shorlee/TeleSTERN/accelerometer.kicad_sch

## KiCad design accelerometer.kicad_sch (2024-08-02)

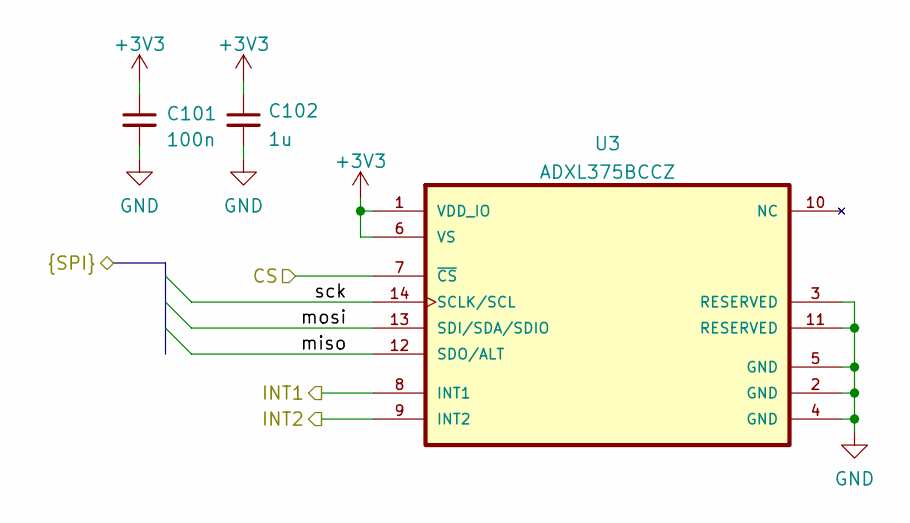
[picture p3: schematic accelerometer.kicad_sch]

Parts:
C101: 100n; C_0402_1005Metric; MPN C1005X5R1E104K050BC
C102: 1u; C_0402_1005Metric; MPN CL05A105KP5NNNC
U3: ADXL375BCCZ; ad-lga-14; MPN ADXL375BCCZ

Connections:
+3V3: C101.1, C102.1, U3.1 (VDD_IO), U3.6 (VS)
CS: U3.7 (~CS)
GND: C101.2, C102.2, U3.2 (GND), U3.3 (RESERVED), U3.4 (GND), U3.5 (GND), U3.11 (RESERVED)
INT1: U3.8 (INT1)
INT2: U3.9 (INT2)
miso: U3.12 (SDO/ALT)
mosi: U3.13 (SDI/SDA/SDIO)
sck: U3.14 (SCLK/SCL)
