shorlee/TeleSTERN/barometer.kicad_sch

## KiCad design barometer.kicad_sch (2024-08-02)

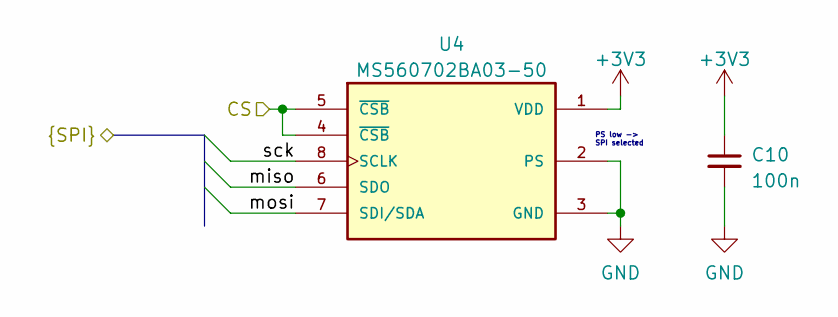
[picture p4: schematic barometer.kicad_sch]

Parts:
C10: 100n; C_0402_1005Metric; MPN C1005X5R1E104K050BC
U4: MS560702BA03-50; SON125P300X500X100-8N; MPN MS560702BA03-50

Connections:
+3V3: C10.1, U4.1 (VDD)
CS: U4.4 (~CSB), U4.5 (~CSB)
GND: C10.2, U4.2 (PS), U4.3 (GND)
miso: U4.6 (SDO)
mosi: U4.7 (SDI/SDA)
sck: U4.8 (SCLK)

Notes on the sheet:
PS low -> SPI selected
