shorlee/TeleSTERN/gps.kicad_sch

## KiCad design gps.kicad_sch (2024-08-02)

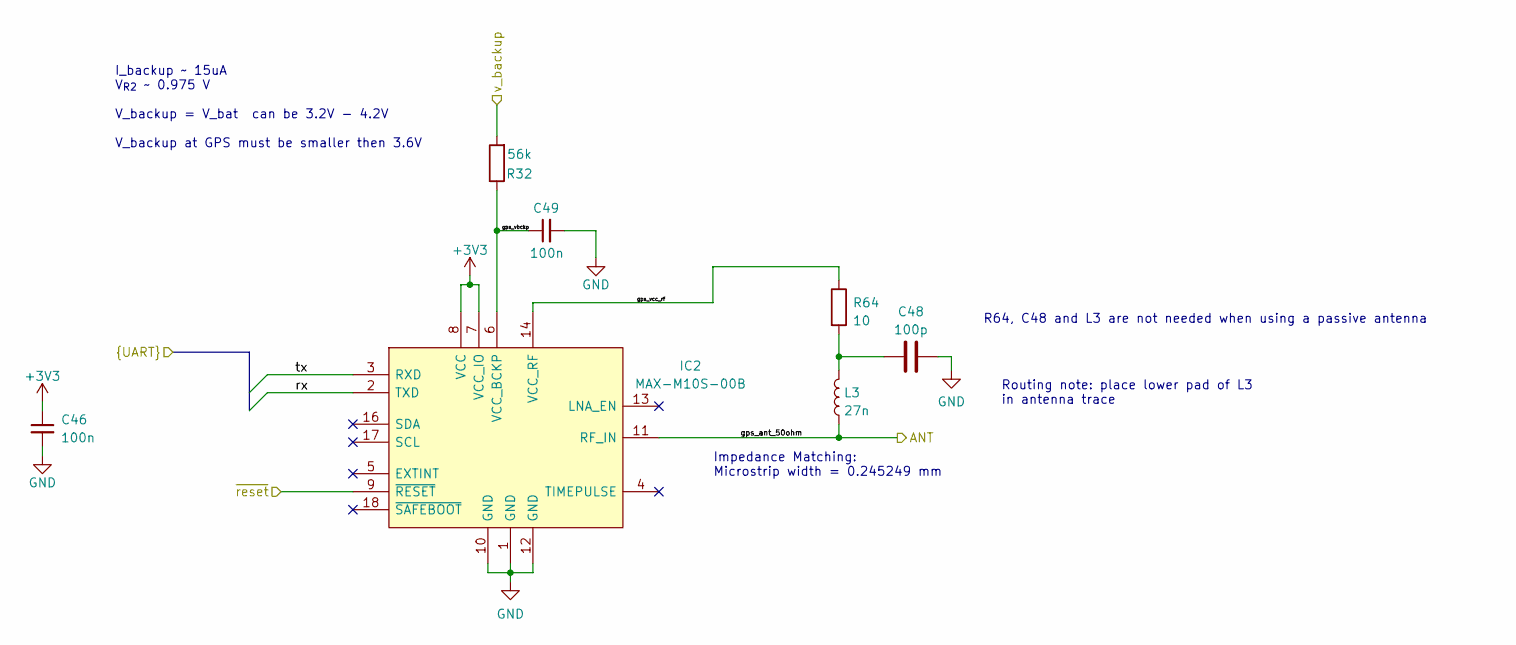
[picture p5: schematic gps.kicad_sch]

Parts:
C46, C49: 100n; C_0402_1005Metric; MPN C1005X5R1E104K050BC
C48: 100p; C_0402_1005Metric; MPN CGA2B2NP01H101J050BA
IC2: MAX-M10S-00B; MAXM10S00B; MPN MAX-M10S-00B; Digikey 672-MAX-M10S-00BTR-ND
L3: 27n; L_0402_1005Metric; MPN LQG15HS27NJ02D
R32: 56k; R_0402_1005Metric; MPN ERJ-U02F5602X
R64: 10; R_0402_1005Metric; MPN 603-RC0402FR-7W10RL

Connections:
+3V3: C46.1, IC2.7 (VCC_IO), IC2.8 (VCC)
ANT: IC2.11 (RF_IN), L3.1
GND: C46.2, C48.2, C49.2, IC2.1 (GND), IC2.10 (GND), IC2.12 (GND)
unnamed: C48.1, L3.2, R64.2
gps_vbckp: C49.1, IC2.6 (VCC_BCKP), R32.1
gps_vcc_rf: IC2.14 (VCC_RF), R64.1
rx: IC2.2 (TXD)
tx: IC2.3 (RXD)
v_backup: R32.2
~reset: IC2.9 (~RESET)

Notes on the sheet:
Impedance Matching: Microstrip width = 0.245249 mm
I_backup ~ 15uA V_{R2} ~ 0.975 V V_backup = V_bat can be 3.2V - 4.2V V_backup at GPS must be smaller then 3.6V
Routing note: place lower pad of L3 in antenna trace
R64, C48 and L3 are not needed when using a passive antenna
