shorlee/TeleSTERN/hw-tele-stern.kicad_sch

## KiCad design hw-tele-stern.kicad_sch (2024-08-02)

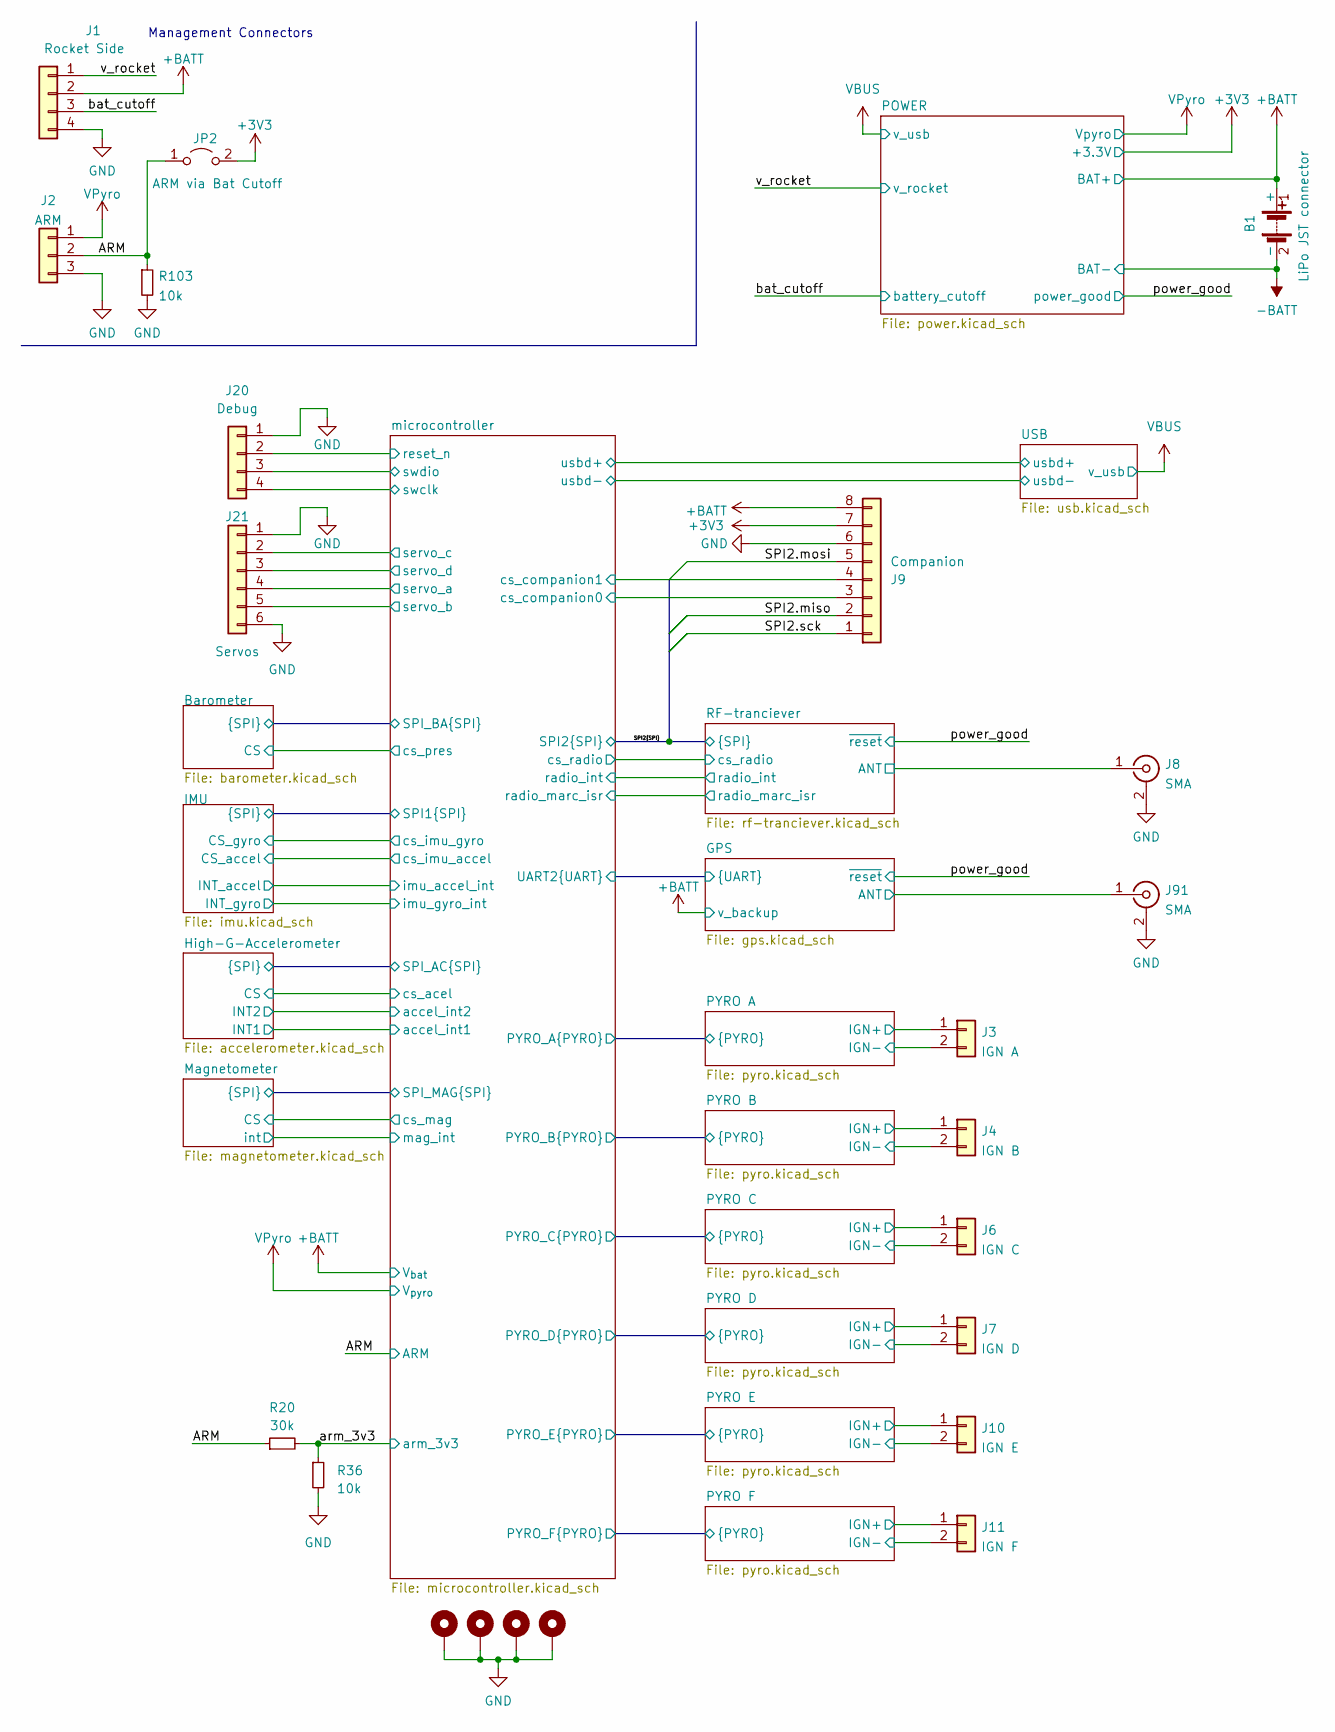
[picture p6: schematic hw-tele-stern.kicad_sch]

Parts:
B1: LiPo JST connector; TE_JST_1x2pin; MPN 440054-2
H1, H2, H3, H4: MountingHole_Pad; MountingHole_3.2mm_M3_DIN965_Pad
J1: Rocket Side; Molex_Nano-Fit_105313-xx04_1x04_P2.50mm_Horizontal; MPN 105313-1104
J2: ARM; Molex_Nano-Fit_105313-xx03_1x03_P2.50mm_Horizontal; MPN 105313-1103
J3: IGN A; Molex_Nano-Fit_105313-xx02_1x02_P2.50mm_Horizontal; MPN 105313-1102
J4: IGN B; Molex_Nano-Fit_105313-xx02_1x02_P2.50mm_Horizontal; MPN 105313-1102
J6: IGN C; Molex_Nano-Fit_105313-xx02_1x02_P2.50mm_Horizontal; MPN 105313-1102
J7: IGN D; Molex_Nano-Fit_105313-xx02_1x02_P2.50mm_Horizontal; MPN 105313-1102
J8, J91: SMA; SMA_Molex_73251-2120_EdgeMount_Horizontal; MPN 73251-2120
J9: Companion; Molex_Nano-Fit_105310-xx08_2x04_P2.50mm_Vertical; MPN 538-105310-1208
J10: IGN E; Molex_Nano-Fit_105313-xx02_1x02_P2.50mm_Horizontal; MPN 105313-1102
J11: IGN F; Molex_Nano-Fit_105313-xx02_1x02_P2.50mm_Horizontal; MPN 105313-1102
J20: Debug; PinHeader_1x04_P2.54mm_Vertical
J21: Servos; Molex_Nano-Fit_105310-xx06_2x03_P2.50mm_Vertical; MPN 538-105310-1206
JP2: ARM via Bat Cutoff; SolderJumper-2_P1.3mm_Open_Pad1.0x1.5mm
R20: 30k; R_0402_1005Metric; MPN RC0402FR-0760K4L
R36, R103: 10k; R_0402_1005Metric; MPN CRGP0402F10K

Connections:
+3V3: J9.7, JP2.2 (B)
+BATT: B1.1 (+), J1.2, J9.8
-BATT: B1.2 (-)
ANT: J8.1 (In), J91.1 (In)
ARM: J2.2, JP2.1 (A), R20.1, R103.1
GND: H1.1, H2.1, H3.1, H4.1, J1.4, J2.3, J8.2 (Ext), J9.6, J20.1, J21.1, J21.6, J91.2 (Ext), R36.2, R103.2
IGN+: J3.1, J4.1, J6.1, J7.1, J10.1, J11.1
IGN-: J3.2, J4.2, J6.2, J7.2, J10.2, J11.2
SPI2.miso: J9.2
SPI2.mosi: J9.5
SPI2.sck: J9.1
VPyro: J2.1
arm_3v3: R20.2, R36.1
bat_cutoff: J1.3
cs_companion0: J9.3
cs_companion1: J9.4
reset_n: J20.2
servo_a: J21.4
servo_b: J21.5
servo_c: J21.2
servo_d: J21.3
swclk: J20.4
swdio: J20.3
v_rocket: J1.1

Notes on the sheet:
Management Connectors
