shorlee/TeleSTERN/imu.kicad_sch

## KiCad design imu.kicad_sch (2024-08-02)

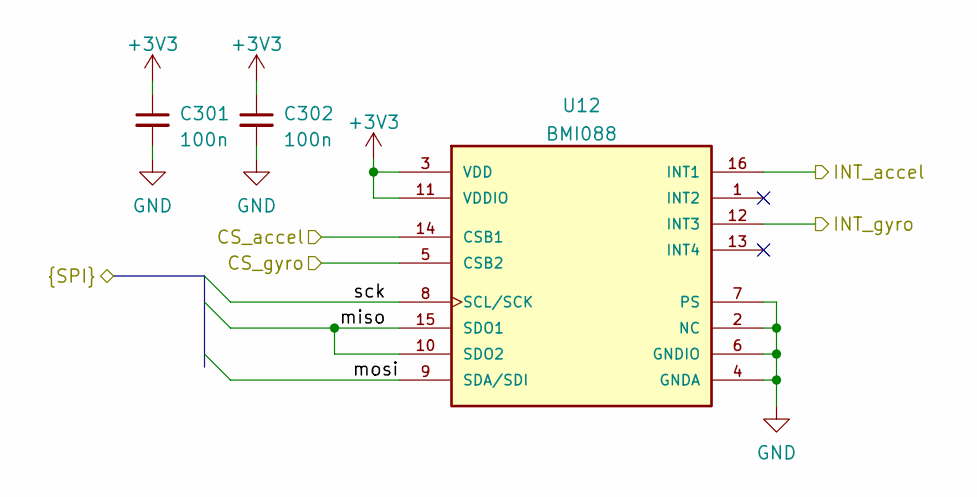
[picture p7: schematic imu.kicad_sch]

Parts:
C301, C302: 100n; C_0402_1005Metric; MPN C1005X5R1E104K050BC
U12: BMI088; bosch-lga-16; MPN BMI088

Connections:
+3V3: C301.1, C302.1, U12.3 (VDD), U12.11 (VDDIO)
CS_accel: U12.14 (CSB1)
CS_gyro: U12.5 (CSB2)
GND: C301.2, C302.2, U12.2 (NC), U12.4 (GNDA), U12.6 (GNDIO), U12.7 (PS)
INT_accel: U12.16 (INT1)
INT_gyro: U12.12 (INT3)
miso: U12.10 (SDO2), U12.15 (SDO1)
mosi: U12.9 (SDA/SDI)
sck: U12.8 (SCL/SCK)
