shorlee/TeleSTERN/magnetometer.kicad_sch

## KiCad design magnetometer.kicad_sch (2024-08-02)

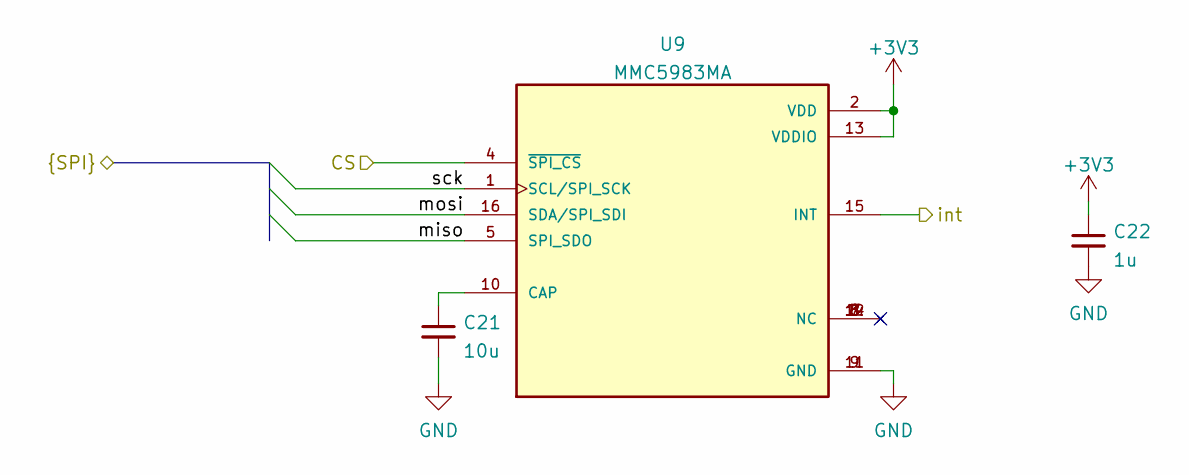
[picture p8: schematic magnetometer.kicad_sch]

Parts:
C21: 10u; C_0402_1005Metric; MPN 04026D106MAT2A
C22: 1u; C_0402_1005Metric; MPN CL05A105KP5NNNC
U9: MMC5983MA; memsic-lga-16; MPN MMC5983MA

Connections:
+3V3: C22.1, U9.2 (VDD), U9.13 (VDDIO)
CS: U9.4 (~SPI_CS)
GND: C21.2, C22.2, U9.9 (GND), U9.11 (GND)
unnamed: C21.1, U9.10 (CAP)
unnamed: U9.3 (NC), U9.6 (NC), U9.7 (NC), U9.8 (NC), U9.12 (NC), U9.14 (NC)
int: U9.15 (INT)
miso: U9.5 (SPI_SDO)
mosi: U9.16 (SDA/SPI_SDI)
sck: U9.1 (SCL/SPI_SCK)
