shorlee/TeleSTERN/microcontroller.kicad_sch

## KiCad design microcontroller.kicad_sch (2024-08-02)

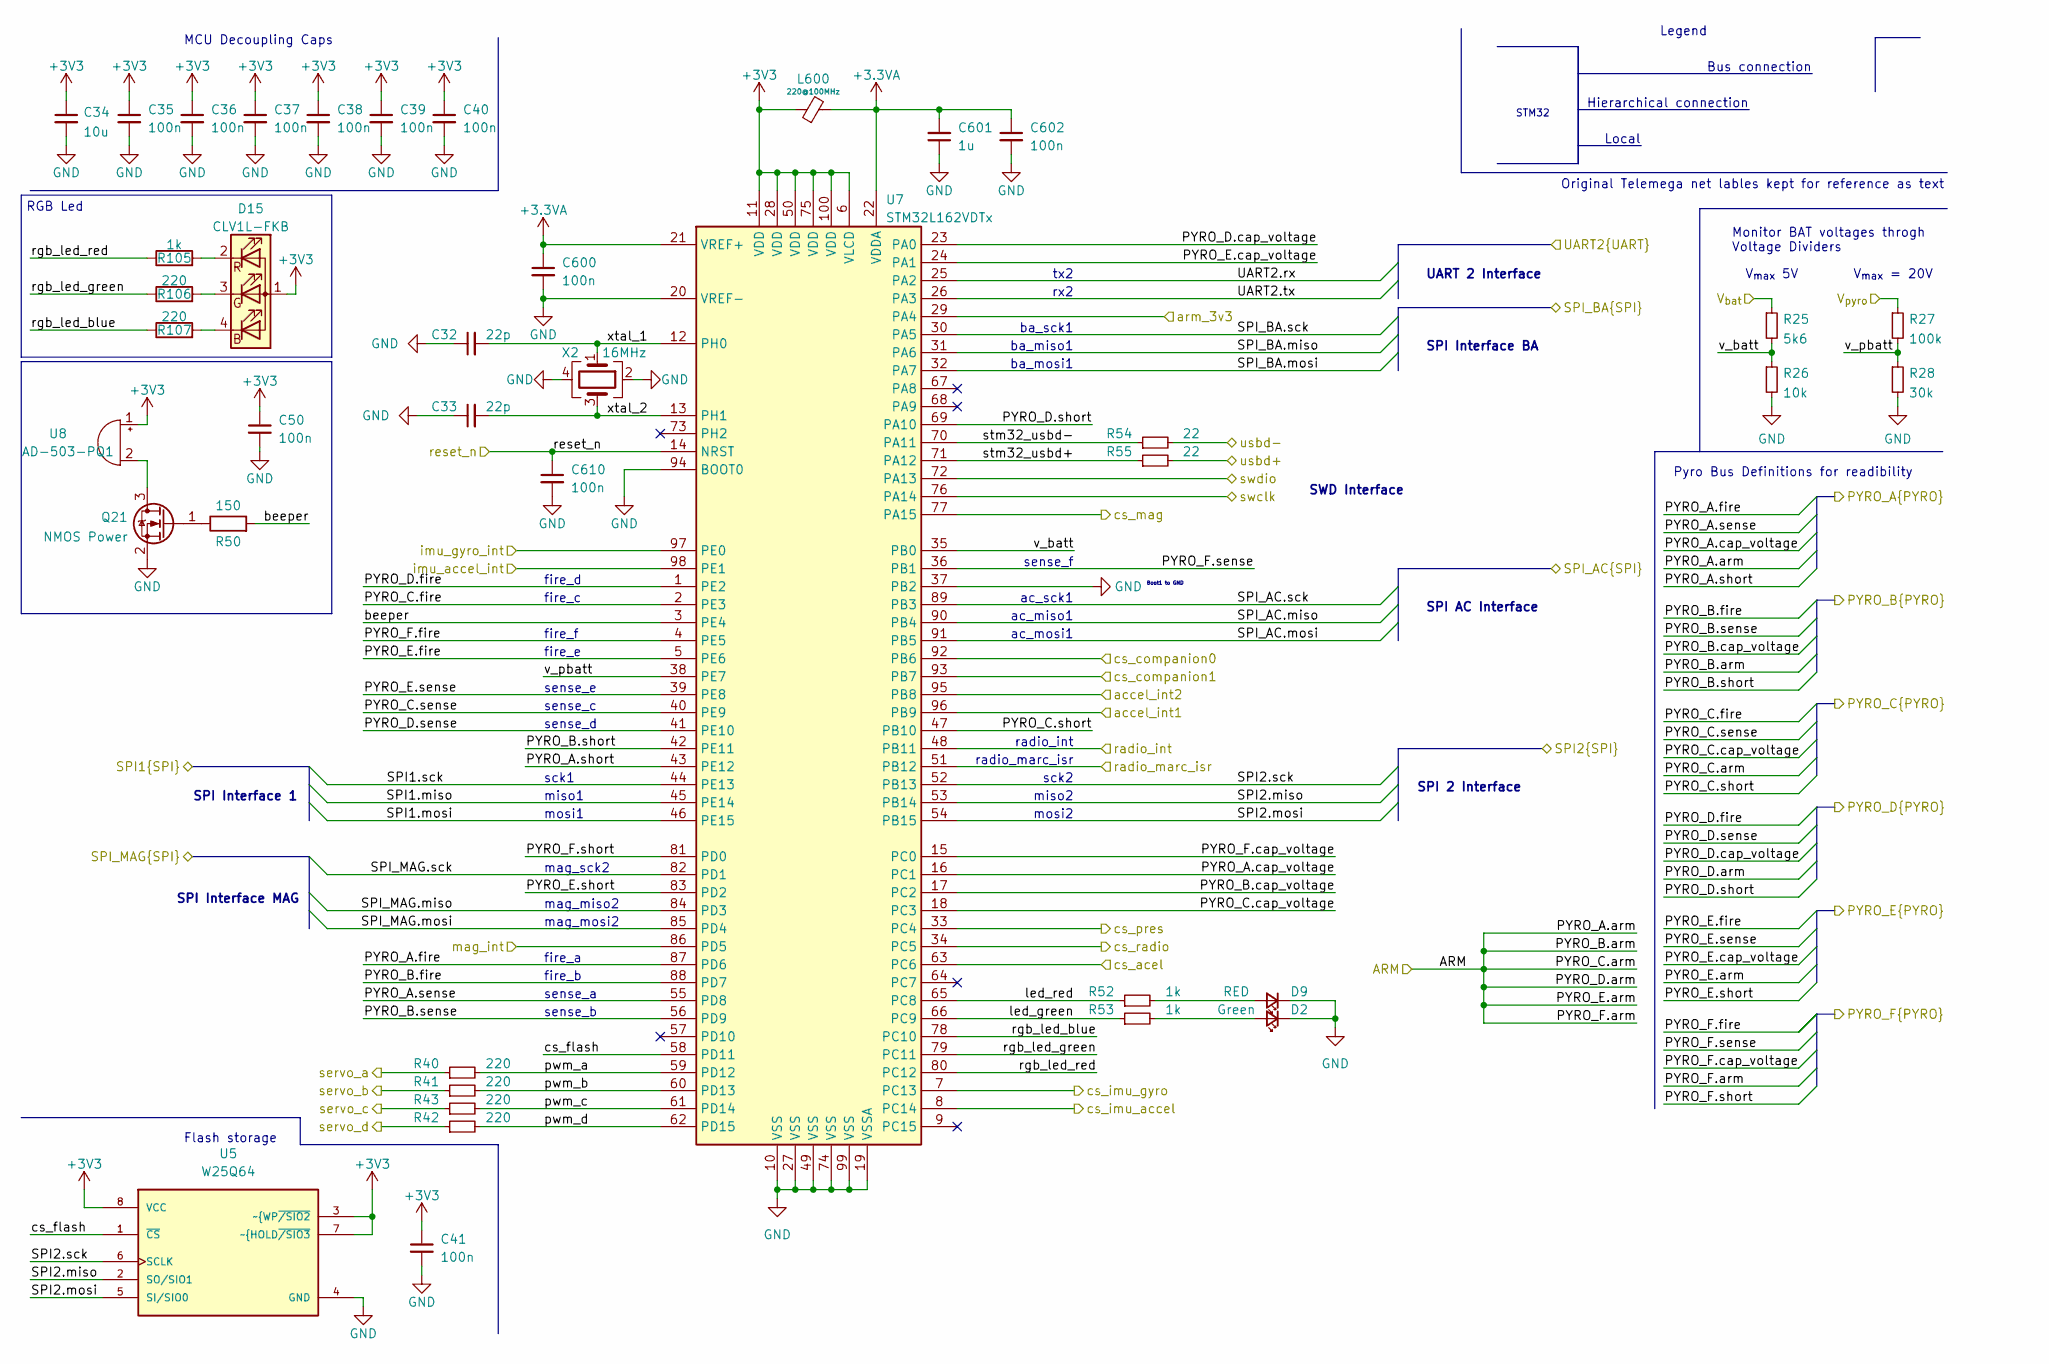
[picture p9: schematic microcontroller.kicad_sch]

Parts:
C32, C33: 22p; C_0402_1005Metric; MPN GRM1555C1H220FA01D
C34: 10u; C_0402_1005Metric; MPN 04026D106MAT2A
C35, C36, C37, C38, C39, C40, C41, C50, C600, C602, C610: 100n; C_0402_1005Metric; MPN C1005X5R1E104K050BC
C601: 1u; C_0402_1005Metric; MPN CL05A105KP5NNNC
D2: Green; LED_0402_1005Metric; MPN 150040VS73220
D9: RED; LED_0402_1005Metric; MPN 150040VS73220
D15: CLV1L-FKB; LED_Cree-PLCC4_3.2x2.8mm_CCW; MPN 941-CLV1LFKBCJQ79353
L600: 220@100MHz; L_0402_1005Metric; MPN LI0402C221R-10
Q21: NMOS Power; Vishay_PowerPAK_SC70-6L_Single; MPN SIA432DJ-T1-GE3
R25: 5k6; R_0402_1005Metric; MPN ERJ-2RKF5601X
R26: 10k; R_0402_1005Metric; MPN CRGP0402F10K
R27: 100k; R_0402_1005Metric; MPN RC0402FR-07100KL
R28: 30k; R_0402_1005Metric; MPN RC0402FR-0760K4L
R40, R41, R42, R43, R106, R107: 220; R_0402_1005Metric; MPN RK73H1ETTP2200F
R50: 150; R_0402_1005Metric; MPN RC0402FR-07150RL
R52, R53, R105: 1k; R_0402_1005Metric; MPN CR0402-FX-1001GLF
R54, R55: 22; R_0402_1005Metric; MPN RK73H1ETTP22R0F
U5: W25Q64; SOIC127P790X216-8N; MPN MX25L6433FM2I-08G
U7: STM32L162VDTx; LQFP-100_14x14mm_P0.5mm; MPN STM32L162VDT6
U8: AD-503-PQ1; AD-504-PQ1; MPN 253-AD503PQ1
X2: 16MHz; Crystal_SMD_Abracon_ABM10-4Pin_2.5x2.0mm; MPN FA-20H 16.0000MF10Z-AJ0

Connections:
+3.3VA: C600.1, C601.2, C602.1, L600.2, U7.21 (VREF+), U7.22 (VDDA)
+3V3: C34.1, C35.1, C36.1, C37.1, C38.1, C39.1, C40.1, C41.1, C50.1, D15.1 (A), L600.1, U5.3 (~WP~{/SIO2), U5.7 (~HOLD~{/SIO3), U5.8 (VCC), U7.6 (VLCD), U7.11 (VDD), U7.28 (VDD), U7.50 (VDD), U7.75 (VDD), U7.100 (VDD), U8.1 (-)
GND: C32.1, C33.1, C34.2, C35.2, C36.2, C37.2, C38.2, C39.2, C40.2, C41.2, C50.2, C600.2, C601.1, C602.2, C610.2, D2.1 (K), D9.1 (K), Q21.2 (S), R26.2, R28.2, U5.4 (GND), U7.10 (VSS), U7.19 (VSSA), U7.20 (VREF-), U7.27 (VSS), U7.37 (PB2), U7.49 (VSS), U7.74 (VSS), U7.94 (BOOT0), U7.99 (VSS), X2.2, X2.4
unnamed: D2.2 (A), R53.2
unnamed: D9.2 (A), R52.2
unnamed: D15.2 (RK), R105.2
unnamed: D15.3 (GK), R106.2
unnamed: D15.4 (BK), R107.2
unnamed: Q21.1 (G), R50.1
unnamed: Q21.3 (D), U8.2 (+)
PYRO_A.cap_voltage: U7.16 (PC1)
PYRO_A.fire: U7.87 (PD6)
PYRO_A.sense: U7.55 (PD8)
PYRO_A.short: U7.43 (PE12)
PYRO_B.cap_voltage: U7.17 (PC2)
PYRO_B.fire: U7.88 (PD7)
PYRO_B.sense: U7.56 (PD9)
PYRO_B.short: U7.42 (PE11)
PYRO_C.cap_voltage: U7.18 (PC3)
PYRO_C.fire: U7.2 (PE3)
PYRO_C.sense: U7.40 (PE9)
PYRO_C.short: U7.47 (PB10)
PYRO_D.cap_voltage: U7.23 (PA0)
PYRO_D.fire: U7.1 (PE2)
PYRO_D.sense: U7.41 (PE10)
PYRO_D.short: U7.69 (PA10)
PYRO_E.cap_voltage: U7.24 (PA1)
PYRO_E.fire: U7.5 (PE6)
PYRO_E.sense: U7.39 (PE8)
PYRO_E.short: U7.83 (PD2)
PYRO_F.cap_voltage: U7.15 (PC0)
PYRO_F.fire: U7.4 (PE5)
PYRO_F.sense: U7.36 (PB1)
PYRO_F.short: U7.81 (PD0)
SPI1.miso: U7.45 (PE14)
SPI1.mosi: U7.46 (PE15)
SPI1.sck: U7.44 (PE13)
SPI2.miso: U5.2 (SO/SIO1), U7.53 (PB14)
SPI2.mosi: U5.5 (SI/SIO0), U7.54 (PB15)
SPI2.sck: U5.6 (SCLK), U7.52 (PB13)
SPI_AC.miso: U7.90 (PB4)
SPI_AC.mosi: U7.91 (PB5)
SPI_AC.sck: U7.89 (PB3)
SPI_BA.miso: U7.31 (PA6)
SPI_BA.mosi: U7.32 (PA7)
SPI_BA.sck: U7.30 (PA5)
SPI_MAG.miso: U7.84 (PD3)
SPI_MAG.mosi: U7.85 (PD4)
SPI_MAG.sck: U7.82 (PD1)
UART2.rx: U7.25 (PA2)
UART2.tx: U7.26 (PA3)
V_{bat}: R25.1
V_{pyro}: R27.1
accel_int1: U7.96 (PB9)
accel_int2: U7.95 (PB8)
arm_3v3: U7.29 (PA4)
beeper: R50.2, U7.3 (PE4)
cs_acel: U7.63 (PC6)
cs_companion0: U7.92 (PB6)
cs_companion1: U7.93 (PB7)
cs_flash: U5.1 (~CS), U7.58 (PD11)
cs_imu_accel: U7.8 (PC14)
cs_imu_gyro: U7.7 (PC13)
cs_mag: U7.77 (PA15)
cs_pres: U7.33 (PC4)
cs_radio: U7.34 (PC5)
imu_accel_int: U7.98 (PE1)
imu_gyro_int: U7.97 (PE0)
led_green: R53.1, U7.66 (PC9)
led_red: R52.1, U7.65 (PC8)
mag_int: U7.86 (PD5)
pwm_a: R40.2, U7.59 (PD12)
pwm_b: R41.2, U7.60 (PD13)
pwm_c: R43.2, U7.61 (PD14)
pwm_d: R42.2, U7.62 (PD15)
radio_int: U7.48 (PB11)
radio_marc_isr: U7.51 (PB12)
reset_n: C610.1, U7.14 (NRST)
rgb_led_blue: R107.1, U7.78 (PC10)
rgb_led_green: R106.1, U7.79 (PC11)
rgb_led_red: R105.1, U7.80 (PC12)
servo_a: R40.1
servo_b: R41.1
servo_c: R43.1
servo_d: R42.1
stm32_usbd+: R55.1, U7.71 (PA12)
stm32_usbd-: R54.1, U7.70 (PA11)
swclk: U7.76 (PA14)
swdio: U7.72 (PA13)
usbd+: R55.2
usbd-: R54.2
v_batt: R25.2, R26.1, U7.35 (PB0)
v_pbatt: R27.2, R28.1, U7.38 (PE7)
xtal_1: C32.2, U7.12 (PH0), X2.1
xtal_2: C33.2, U7.13 (PH1), X2.3

Notes on the sheet:
Local
mosi1
MCU Decoupling Caps
fire_e
mag_sck2
RGB Led
fire_b
fire_d
ba_mosi1
ba_sck1
Original Telemega net lables kept for reference as text
SPI Interface BA
Monitor BAT voltages throgh Voltage Dividers
tx2
Flash storage
V_{max} = 20V
STM32
SPI AC Interface
sense_a
mosi2
rx2
fire_f
Pyro Bus Definitions for readibility
mag_miso2
Hierarchical connection
sense_d
V_{max} 5V
fire_a
ac_miso1
sense_e
miso2
radio_marc_isr
ba_miso1
UART 2 Interface
fire_c
SPI Interface 1
SPI 2 Interface
Bus connection
sense_b
sense_f
Legend
miso1
SPI Interface MAG
Boot1 to GND
ac_mosi1
sck1
mag_mosi2
SWD Interface
radio_int
ac_sck1
sck2
sense_c
