shorlee/TeleSTERN/power.kicad_sch

## KiCad design power.kicad_sch (2024-08-02)

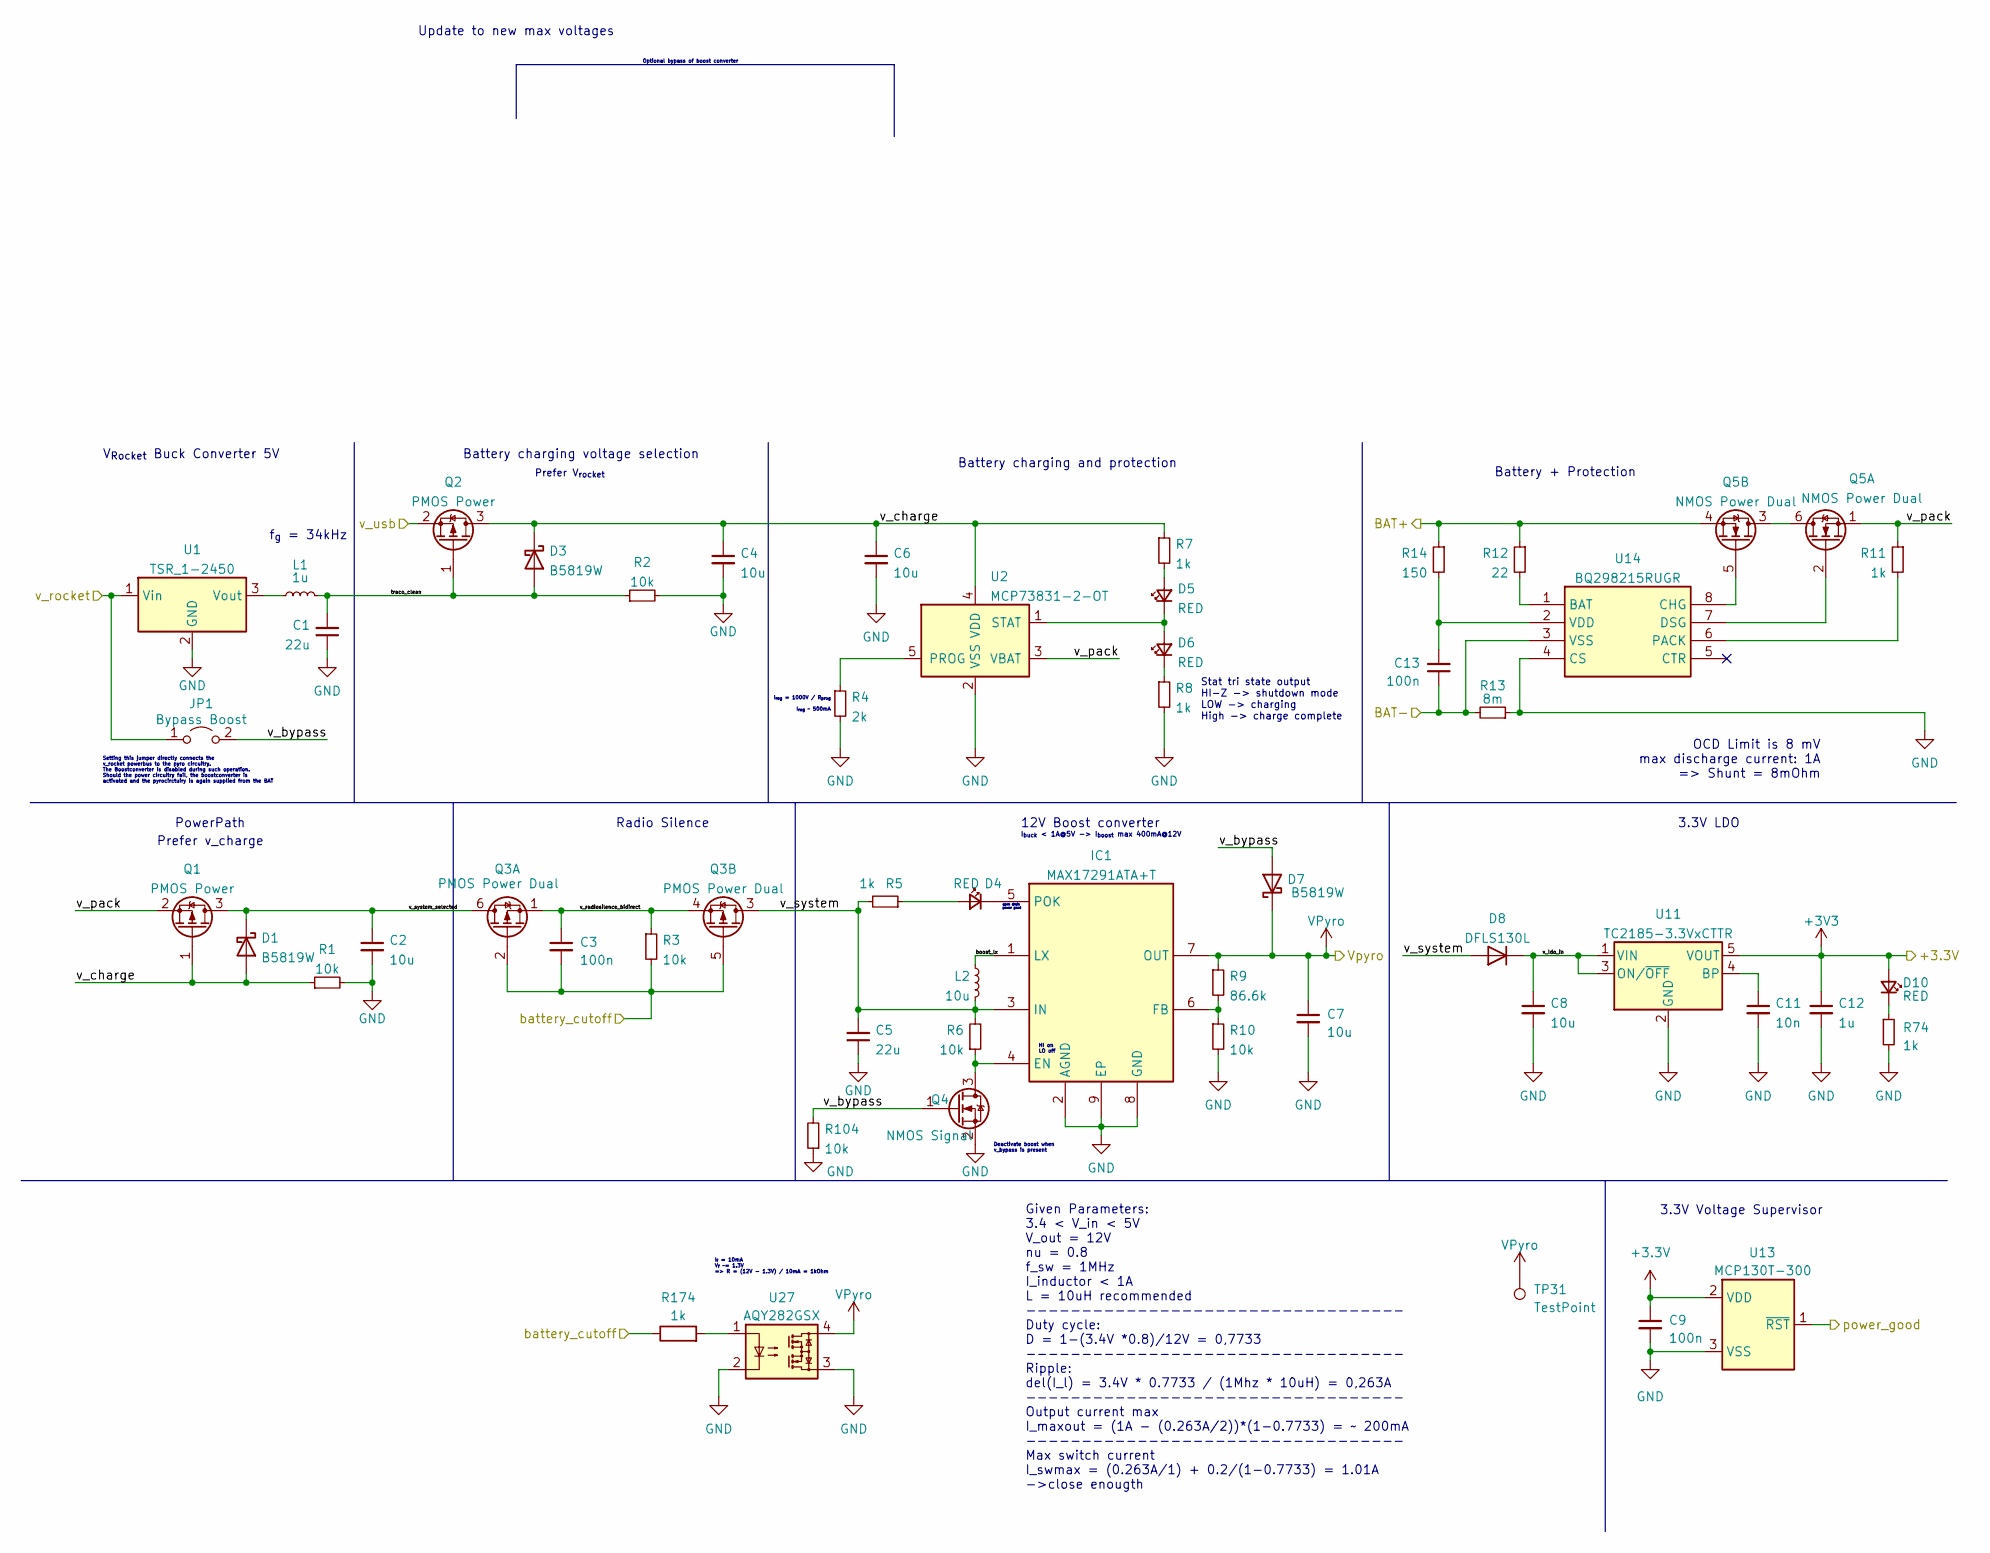
[picture p10: schematic power.kicad_sch]

Parts:
C1, C5: 22u; C_0805_2012Metric; MPN CL21A226MAYNNNE
C2, C4, C6: 10u; C_0402_1005Metric; MPN 04026D106MAT2A
C3, C9, C13: 100n; C_0402_1005Metric; MPN C1005X5R1E104K050BC
C7, C8: 10u; C_0805_2012Metric; MPN CL21B106KAYQNNE
C11: 10n; C_0402_1005Metric; MPN 250R07W103KV4T
C12: 1u; C_0402_1005Metric; MPN CL05A105KP5NNNC
D1, D3, D7: B5819W; D_SOD-123; MPN B5819W-TP
D4, D5, D6, D10: RED; LED_0402_1005Metric; MPN 150040VS73220
D8: DFLS130L; D_PowerDI-123; MPN DFLS130LQ-7
IC1: MAX17291ATA+T; ad-TDFN-8p-EP-2x2mm; MPN MAX17291ATA+T
JP1: Bypass Boost; SolderJumper-2_P1.3mm_Open_RoundedPad1.0x1.5mm
L1: 1u; L_0805_2012Metric; MPN 810-TFM201208ALD1R0M
L2: 10u; L_Bourns_SRN6045TA; MPN SRN6045-100M
Q1, Q2: PMOS Power; Vishay_PowerPAK_SC70-6L_Single; MPN SIA469DJ-T1-GE3
Q3: PMOS Power Dual; Vishay_PowerPAK_SC70-6L_Dual; MPN SIA931DJ-T1-GE3
Q4: NMOS Signal; SOT-23; MPN IRLML2803TRPBF
Q5: NMOS Power Dual; Vishay_PowerPAK_SC70-6L_Dual; MPN SIA918EDJ-T1-GE3
R1, R2, R3, R6, R10, R104: 10k; R_0402_1005Metric; MPN CRGP0402F10K
R4: 2k; R_0402_1005Metric; MPN RC0402FR-072KL
R5, R7, R8, R11, R74, R174: 1k; R_0402_1005Metric; MPN CR0402-FX-1001GLF
R9: 86.6k; R_0402_1005Metric; MPN RC0402FR-0786K6L
R12: 22; R_0402_1005Metric; MPN RK73H1ETTP22R0F
R13: 8m; R_0402_1005Metric; MPN 71-WFCP05088L000FE66
R14: 150; R_0402_1005Metric; MPN RC0402FR-07150RL
TP31: TestPoint; TestPoint_Pad_1.0x1.0mm
U1: TSR_1-2450; Converter_DCDC_TRACO_TSR-1_THT; MPN TSR 1-2450
U2: MCP73831-2-OT; SOT-23-5; MPN MCP73831T-2ACI/OT
U11: TC2185-3.3VxCTTR; SOT-23-5; MPN TC2185-3.3VCTTR
U13: MCP130T-300; SOT-23; MPN MCP130T-300I/TT
U14: BQ298215RUGR; TI-2XQFN; MPN BQ298215RUGR
U27: AQY282GSX; SO-4_4.4x4.3mm_P2.54mm; MPN 769-AQY282GSX

Connections:
+3.3V: C9.1, U13.2 (VDD)
+3V3: C12.1, D10.2 (A), U11.5 (VOUT)
BAT+: Q5.4 (S), R12.1, R14.1
BAT-: C13.1, R13.2, U14.3 (VSS)
GND: C1.1, C2.2, C4.2, C5.1, C6.2, C7.2, C8.2, C9.2, C11.2, C12.2, IC1.2 (AGND), IC1.8 (GND), IC1.9 (EP), Q4.2 (S), R1.2, R2.2, R4.2, R8.2, R10.2, R13.1, R74.2, R104.1, U1.2 (GND), U2.2 (VSS), U11.2 (GND), U13.3 (VSS), U14.4 (CS), U27.2, U27.3
unnamed: C11.1, U11.4 (BP)
unnamed: C13.2, R14.2, U14.2 (VDD)
unnamed: D4.1 (K), IC1.5 (POK)
unnamed: D4.2 (A), R5.1
unnamed: D5.1 (K), D6.2 (A), U2.1 (STAT)
unnamed: D5.2 (A), R7.2
unnamed: D6.1 (K), R8.1
unnamed: D10.1 (K), R74.1
unnamed: IC1.4 (EN), Q4.3 (D), R6.1
unnamed: IC1.6 (FB), R9.2, R10.1
unnamed: L1.1, U1.3 (Vout)
unnamed: Q5.2 (G), U14.7 (DSG)
unnamed: Q5.3 (D), Q5.6 (D)
unnamed: Q5.5 (G), U14.8 (CHG)
unnamed: R4.1, U2.5 (PROG)
unnamed: R11.2, U14.6 (PACK)
unnamed: R12.2, U14.1 (BAT)
unnamed: R174.2, U27.1
Vpyro: C7.1, D7.1 (K), IC1.7 (OUT), R9.1, TP31.1, U27.4
battery_cutoff: C3.2, Q3.2 (G), Q3.5 (G), R3.2, R174.1
boost_lx: IC1.1 (LX), L2.2
power_good: U13.1 (~RST)
traco_clean: C1.2, D3.2 (A), L1.2, Q2.1 (G), R2.1
v_bypass: D7.2 (A), JP1.2 (B), Q4.1 (G), R104.2
v_charge: C4.1, C6.1, D1.2 (A), D3.1 (K), Q1.1 (G), Q2.3 (D), R1.1, R7.1, U2.4 (VDD)
v_ldo_in: C8.1, D8.1 (K), U11.1 (VIN), U11.3 (ON/~OFF)
v_pack: Q1.2 (S), Q5.1 (S), R11.1, U2.3 (VBAT)
v_radiosilence_bidirect: C3.1, Q3.1 (S), Q3.4 (S), R3.1
v_rocket: JP1.1 (A), U1.1 (Vin)
v_system: C5.2, D8.2 (A), IC1.3 (IN), L2.1, Q3.3 (D), R5.2, R6.2
v_system_selected: C2.1, D1.1 (K), Q1.3 (D), Q3.6 (D)
v_usb: Q2.2 (S)

Notes on the sheet:
I_{f} = 10mA V_{f} ~= 1.3V => R = (12V - 1.3V) / 10mA = 1kOhm
Battery charging and protection
Update to new max voltages
HI on LO off
Stat tri state output HI-Z -> shutdown mode LOW -> charging High -> charge complete
OCD Limit is 8 mV max discharge current: 1A => Shunt = 8mOhm
Given Parameters: 3.4 < V_in < 5V V_out = 12V nu = 0.8 f_sw = 1MHz I_inductor < 1A L = 10uH recommended ---------------------------------- Duty cycle: D = 1-(3.4V *0.8)/12V = 0,7733 ---------------------------------- Ripple: del(I_l) = 3.4V * 0.7733 / (1Mhz * 10uH) = 0,263A ------------------------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
3.3V LDO
3.3V Voltage Supervisor
V_{Rocket} Buck Converter 5V
Prefer V_{rocket}
Optional bypass of boost converter
Battery + Protection
Deactivate boost when v_bypass is present
Battery charging voltage selection
I_{reg} = 1000V / R_{prog} I_{reg} ~ 500mA
open drain power good
Radio Silence
Prefer v_charge
PowerPath
Setting this jumper directly connects the v_rocket powerbus to the pyro circuitry. The Boostconverter is disabled during such operation. Should the power circuitry fail, the boostconverter is activated and the pyrocirctuiry is again supplied from the BAT
I_{buck} < 1A@5V -> I_{boost} max 400mA@12V
f_{g} = 34kHz
12V Boost converter
