shorlee/TeleSTERN/pyro.kicad_sch

## KiCad design pyro.kicad_sch (2024-08-02)

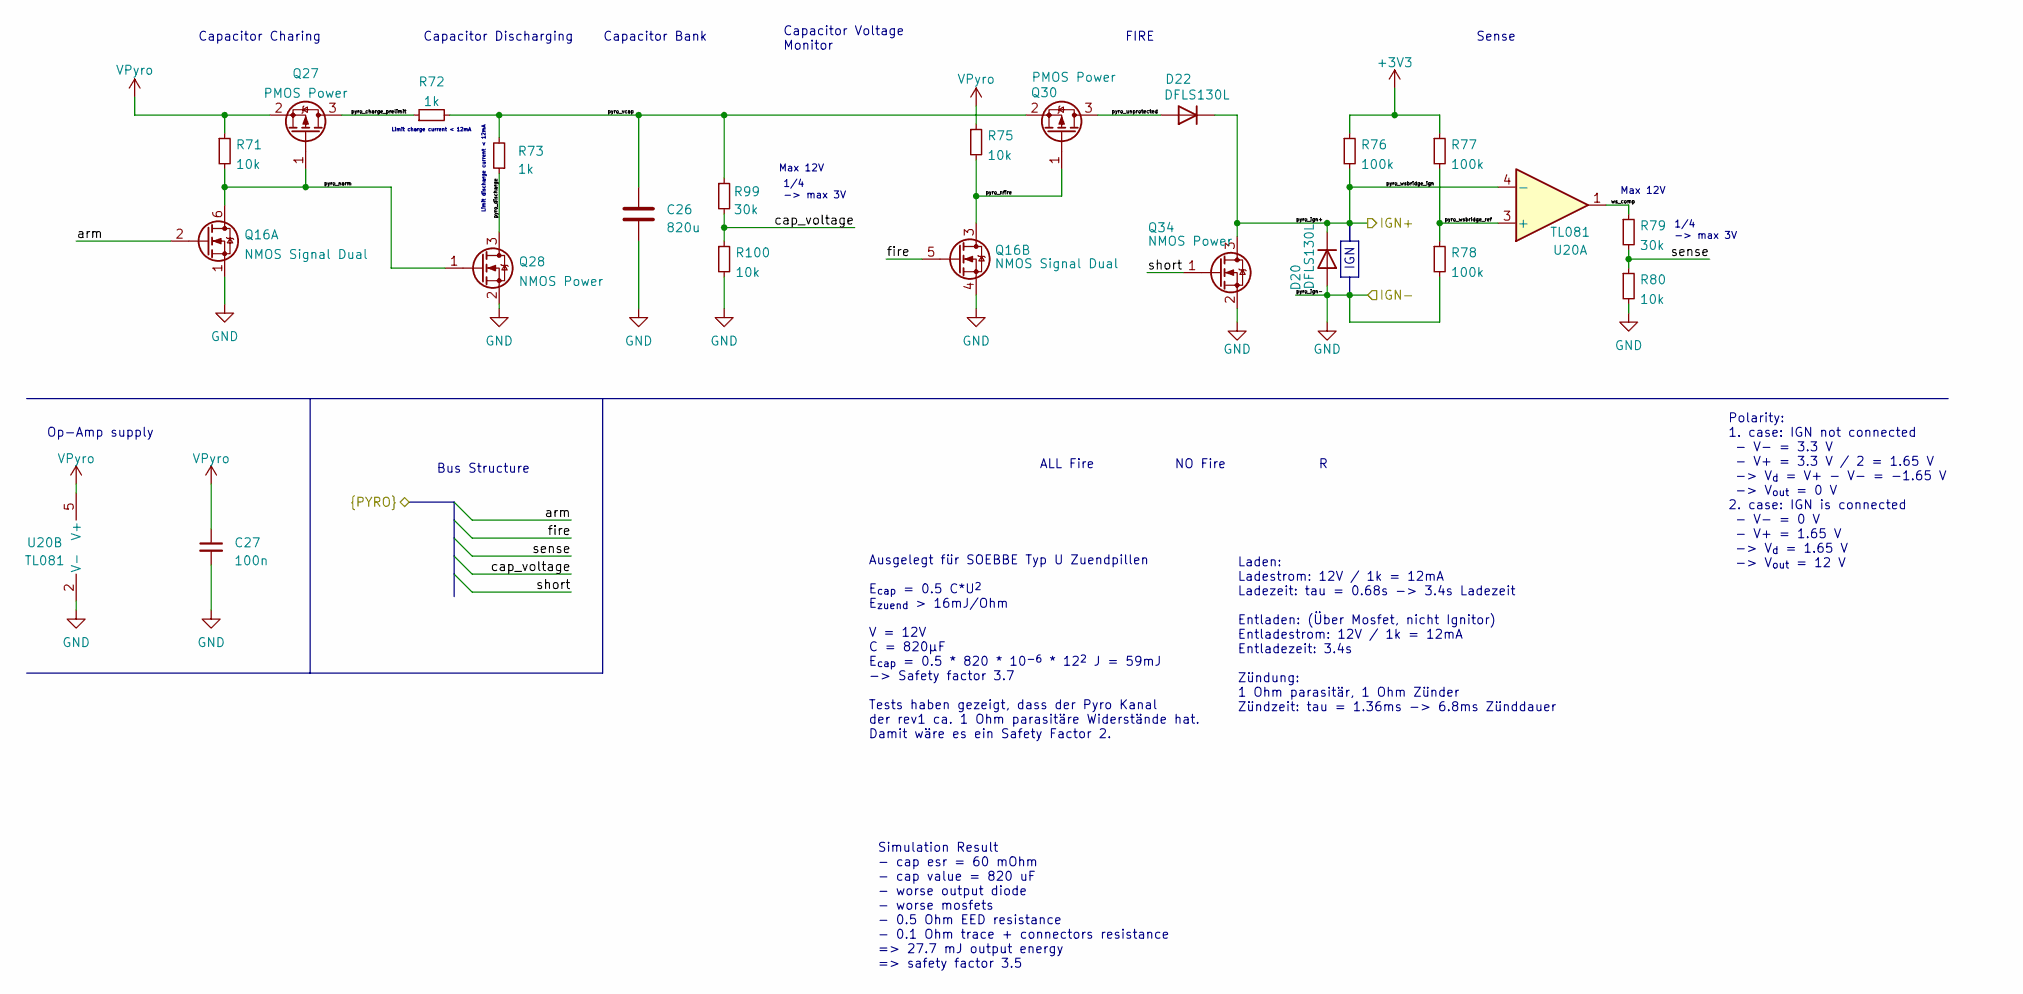
[picture p11: schematic pyro.kicad_sch]

Parts:
C26: 820u; CP_Elec_8x10; MPN 661-EMZL250ARA821MJA
C27: 100n; C_0402_1005Metric; MPN C1005X5R1E104K050BC
D20, D22: DFLS130L; D_PowerDI-123; MPN DFLS130LQ-7
Q16: NMOS Signal Dual; JEITA-sc88; MPN SSM6N15AFU,LF
Q27, Q30: PMOS Power; Vishay_PowerPAK_SC70-6L_Single; MPN SIA469DJ-T1-GE3
Q28, Q34: NMOS Power; Vishay_PowerPAK_SC70-6L_Single; MPN SIA432DJ-T1-GE3
R71, R75, R80, R100: 10k; R_0402_1005Metric; MPN CRGP0402F10K
R72, R73: 1k; R_0402_1005Metric; MPN CR0402-FX-1001GLF
R76, R77, R78: 100k; R_0402_1005Metric; MPN RC0402FR-07100KL
R79, R99: 30k; R_0402_1005Metric; MPN RC0402FR-0760K4L
U20: TL081; SOT-23-5; MPN 595-TL081HIDBVR

Connections:
+3V3: R76.1, R77.1
GND: C26.2, C27.2, D20.2 (A), Q16.1 (S), Q16.4 (S), Q28.2 (S), Q34.2 (S), R78.2, R80.2, R100.2, U20.2 (V-)
IGN+: D20.1 (K), D22.1 (K), Q34.3 (D), R76.2, U20.4 (-)
VPyro: C27.1, Q27.2 (S), R71.1, R75.1, U20.5 (V+)
arm: Q16.2 (G)
cap_voltage: R99.2, R100.1
fire: Q16.5 (G)
pyro_charge_prelimit: Q27.3 (D), R72.1
pyro_discharge: Q28.3 (D), R73.1
pyro_narm: Q16.6 (D), Q27.1 (G), Q28.1 (G), R71.2
pyro_nfire: Q16.3 (D), Q30.1 (G), R75.2
pyro_unprotected: D22.2 (A), Q30.3 (D)
pyro_vcap: C26.1, Q30.2 (S), R72.2, R73.2, R99.1
pyro_wsbridge_ref: R77.2, R78.1, U20.3 (+)
sense: R79.2, R80.1
short: Q34.1 (G)
ws_comp: R79.1, U20.1

Notes on the sheet:
Max 12V
Op-Amp supply
Sense
Limit charge current < 12mA
Capacitor Bank
IGN
1/4 -> max 3V
Ausgelegt für SOEBBE Typ U Zuendpillen E_{cap} = 0.5 C*U^{2} E_{zuend} > 16mJ/Ohm V = 12V C = 820µF E_{cap} = 0.5 * 820 * 10^{-6} * 12^{2} J = 59mJ -> Safety factor 3.7 Tests haben gezeigt, dass der Pyro Kanal der rev1 ca. 1 Ohm parasitäre Widerstände hat. Damit wäre es ein Safety Factor 2.
Simulation Result - cap esr = 60 mOhm - cap value = 820 uF - worse output diode - worse mosfets - 0.5 Ohm EED resistance - 0.1 Ohm trace + connectors resistance => 27.7 mJ output energy => safety factor 3.5
NO Fire
Limit discharge current < 12mA
Capacitor Discharging
Polarity: 1. case: IGN not connected - V- = 3.3 V - V+ = 3.3 V / 2 = 1.65 V -> V_{d} = V+ - V- = -1.65 V -> V_{out} = 0 V 2. case: IGN is connected - V- = 0 V - V+ = 1.65 V -> V_{d} = 1.65 V -> V_{out} = 12 V
Capacitor Charing
Laden: Ladestrom: 12V / 1k = 12mA Ladezeit: tau = 0.68s -> 3.4s Ladezeit Entladen: (Über Mosfet, nicht Ignitor) Entladestrom: 12V / 1k = 12mA Entladezeit: 3.4s Zündung: 1 Ohm parasitär, 1 Ohm Zünder Zündzeit: tau = 1.36ms -> 6.8ms Zünddauer
Bus Structure
ALL Fire
FIRE
Capacitor Voltage Monitor
