shorlee/TeleSTERN/rf-tranciever.kicad_sch

## KiCad design rf-tranciever.kicad_sch (2024-08-02)

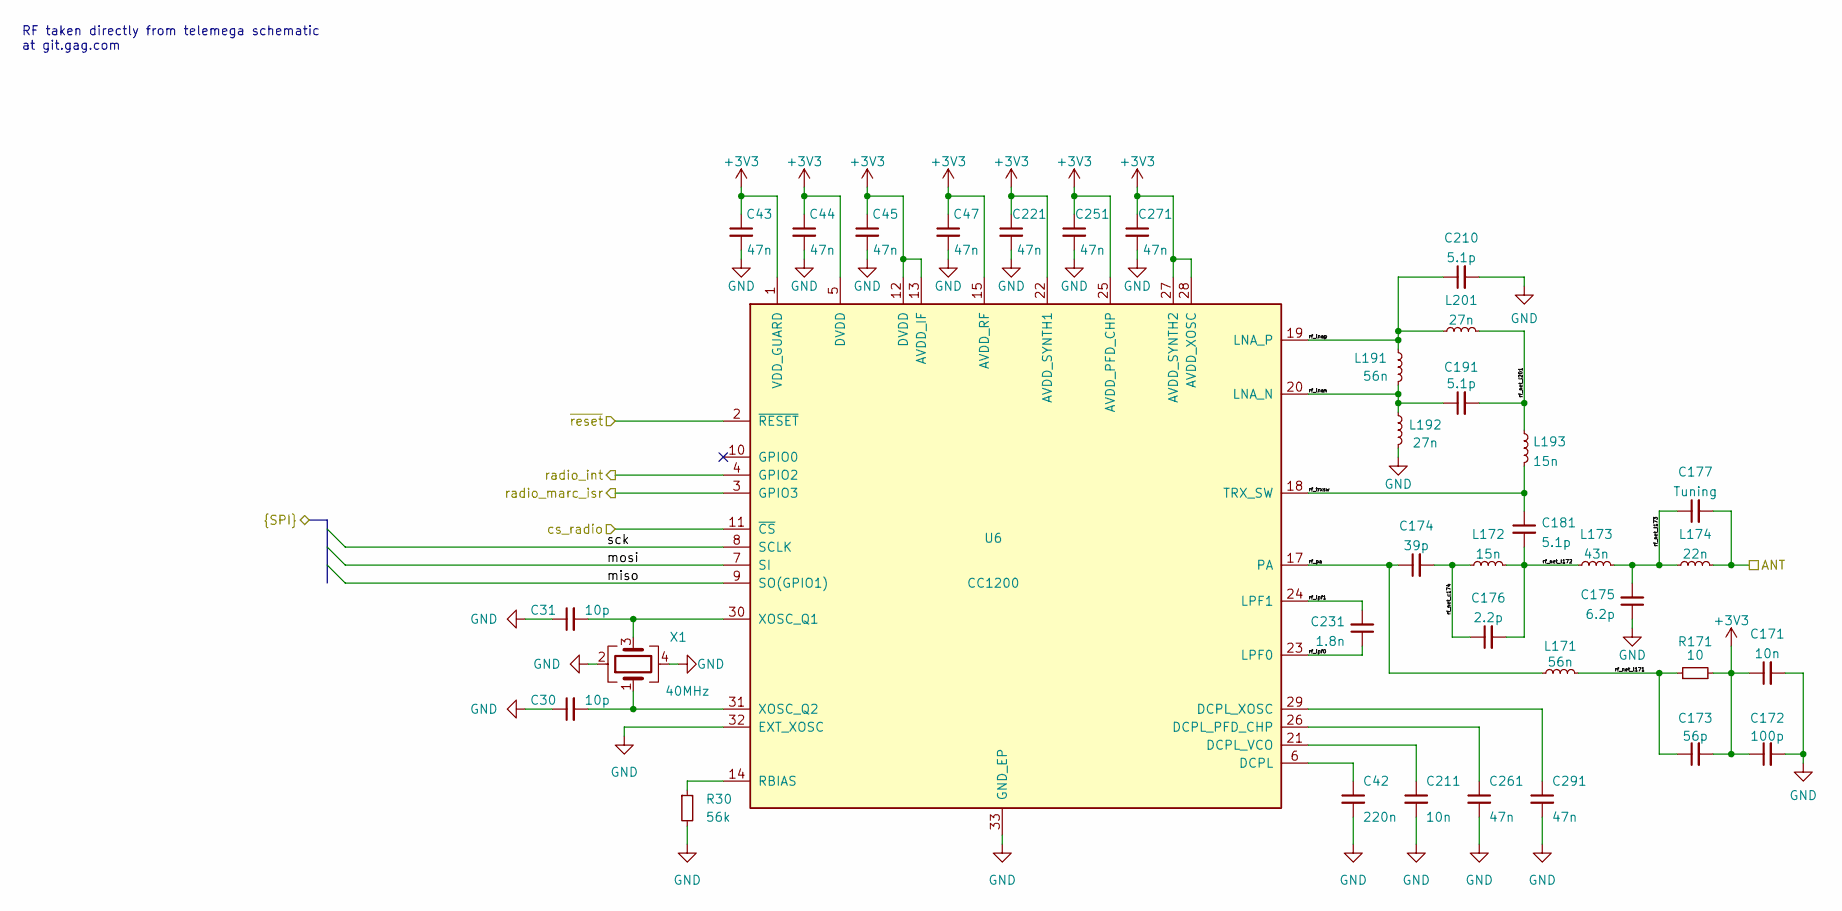
[picture p12: schematic rf-tranciever.kicad_sch]

Parts:
C30, C31: 10p; C_0402_1005Metric; MPN 0402N100J500CT
C42: 220n; C_0402_1005Metric; MPN LMK105BJ224KV-F
C43, C44, C45, C47, C221, C251, C261, C271, C291: 47n; C_0402_1005Metric; MPN CGA2B2X7R1C473K050BA
C171, C211: 10n; C_0402_1005Metric; MPN 250R07W103KV4T
C172: 100p; C_0402_1005Metric; MPN CGA2B2NP01H101J050BA
C173: 56p; C_0402_1005Metric; MPN C0402C560J5GACTU
C174: 39p; C_0402_1005Metric; MPN 791-RF15N390J500CT
C175: 6.2p; C_0402_1005Metric; MPN GJM1555C1H6R2CB01D
C176: 2.2p; C_0402_1005Metric; MPN GJM1555C1H2R2BB01D
C177: Tuning; C_0402_1005Metric
C181, C191, C210: 5.1p; C_0402_1005Metric; MPN C0402C519C5GACTU
C231: 1.8n; C_0402_1005Metric; MPN 04025C182KAT2A
L171, L191: 56n; L_0402_1005Metric; MPN LQG15HS56NJ02D
L172, L193: 15n; L_0402_1005Metric; MPN LQG15HS15NJ02D
L173: 43n; L_0402_1005Metric; MPN MLG1005S43NJT000
L174: 22n; L_0402_1005Metric; MPN LQG15HS22NJ02D
L192, L201: 27n; L_0402_1005Metric; MPN LQG15HS27NJ02D
R30: 56k; R_0402_1005Metric; MPN ERJ-U02F5602X
R171: 10; R_0402_1005Metric; MPN 603-RC0402FR-7W10RL
U6: CC1200; QFN-32-1EP_5x5mm_P0.5mm_EP3.45x3.45mm; MPN CC1200RHBT
X1: 40MHz; Crystal_SMD_Abracon_ABM3B-4Pin_3.2x2.5mm; MPN ABM8W-40.0000MHZ-4-B1U-T3

Connections:
+3V3: C43.1, C44.1, C45.1, C47.1, C171.1, C172.1, C173.2, C221.1, C251.1, C271.1, R171.2, U6.1 (VDD_GUARD), U6.5 (DVDD), U6.12 (DVDD), U6.13 (AVDD_IF), U6.15 (AVDD_RF), U6.22 (AVDD_SYNTH1), U6.25 (AVDD_PFD_CHP), U6.27 (AVDD_SYNTH2), U6.28 (AVDD_XOSC)
ANT: C177.2, L174.2
GND: C30.1, C31.1, C42.2, C43.2, C44.2, C45.2, C47.2, C171.2, C172.2, C175.1, C210.2, C211.2, C221.2, C251.2, C261.2, C271.2, C291.2, L192.2, R30.2, U6.32 (EXT_XOSC), U6.33 (GND_EP), X1.2, X1.4
unnamed: C30.2, U6.31 (XOSC_Q2), X1.1
unnamed: C31.2, U6.30 (XOSC_Q1), X1.3
unnamed: C42.1, U6.6 (DCPL)
unnamed: C211.1, U6.21 (DCPL_VCO)
unnamed: C261.1, U6.26 (DCPL_PFD_CHP)
unnamed: C291.1, U6.29 (DCPL_XOSC)
unnamed: R30.1, U6.14 (RBIAS)
cs_radio: U6.11 (~CS)
miso: U6.9 (SO(GPIO1))
mosi: U6.7 (SI)
radio_int: U6.4 (GPIO2)
radio_marc_isr: U6.3 (GPIO3)
rf_lnan: C191.1, L191.2, L192.1, U6.20 (LNA_N)
rf_lnap: C210.1, L191.1, L201.1, U6.19 (LNA_P)
rf_lpf0: C231.1, U6.23 (LPF0)
rf_lpf1: C231.2, U6.24 (LPF1)
rf_net_c174: C174.2, C176.1, L172.1
rf_net_l171: C173.1, L171.2, R171.1
rf_net_l172: C176.2, C181.2, L172.2, L173.1
rf_net_l173: C175.2, C177.1, L173.2, L174.1
rf_net_l201: C191.2, L193.1, L201.2
rf_pa: C174.1, L171.1, U6.17 (PA)
rf_trxsw: C181.1, L193.2, U6.18 (TRX_SW)
sck: U6.8 (SCLK)
~reset: U6.2 (~RESET)

Notes on the sheet:
RF taken directly from telemega schematic at git.gag.com
