shorlee/TeleSTERN/usb.kicad_sch

## KiCad design usb.kicad_sch (2024-08-02)

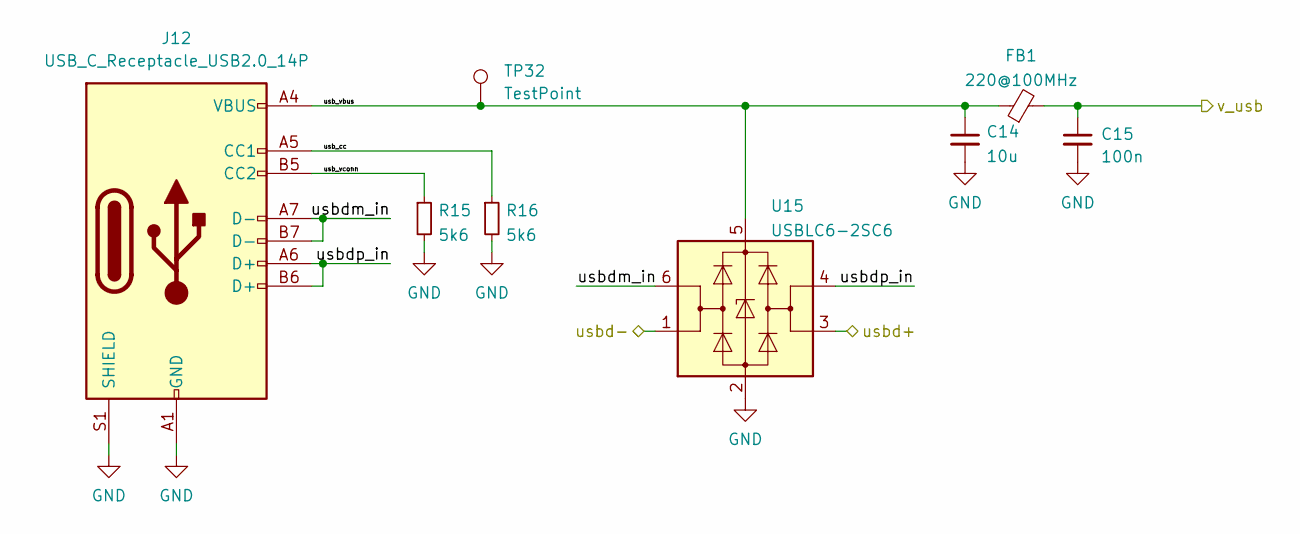
[picture p13: schematic usb.kicad_sch]

Parts:
C14: 10u; C_0402_1005Metric; MPN 04026D106MAT2A
C15: 100n; C_0402_1005Metric; MPN C1005X5R1E104K050BC
FB1: 220@100MHz; L_0402_1005Metric; MPN LI0402C221R-10
J12: USB_C_Receptacle_USB2.0_14P; USB_C_Receptacle_JAE_DX07S016JA1R1500
R15, R16: 5k6; R_0402_1005Metric; MPN ERJ-2RKF5601X
TP32: TestPoint; TestPoint_Pad_1.0x1.0mm
U15: USBLC6-2SC6; SOT-23-6; MPN USBLC6-2SC6

Connections:
GND: C14.2, C15.2, J12.A1 (GND), J12.A12 (GND), J12.B1 (GND), J12.B12 (GND), J12.S1 (SHIELD), R15.2, R16.2, U15.2 (GND)
usb_cc: J12.A5 (CC1), R16.1
usb_vbus: C14.1, FB1.1, J12.A4 (VBUS), J12.A9 (VBUS), J12.B4 (VBUS), J12.B9 (VBUS), TP32.1, U15.5 (VBUS)
usb_vconn: J12.B5 (CC2), R15.1
usbd+: U15.3 (I/O2)
usbd-: U15.1 (I/O1)
usbdm_in: J12.A7 (D-), J12.B7 (D-), U15.6 (I/O1)
usbdp_in: J12.A6 (D+), J12.B6 (D+), U15.4 (I/O2)
v_usb: C15.1, FB1.2
